rglenn/botboard/BotBoard0507/Documentation/BB07Pro/Photos/Assembly Photos/HPIM0253.JPG

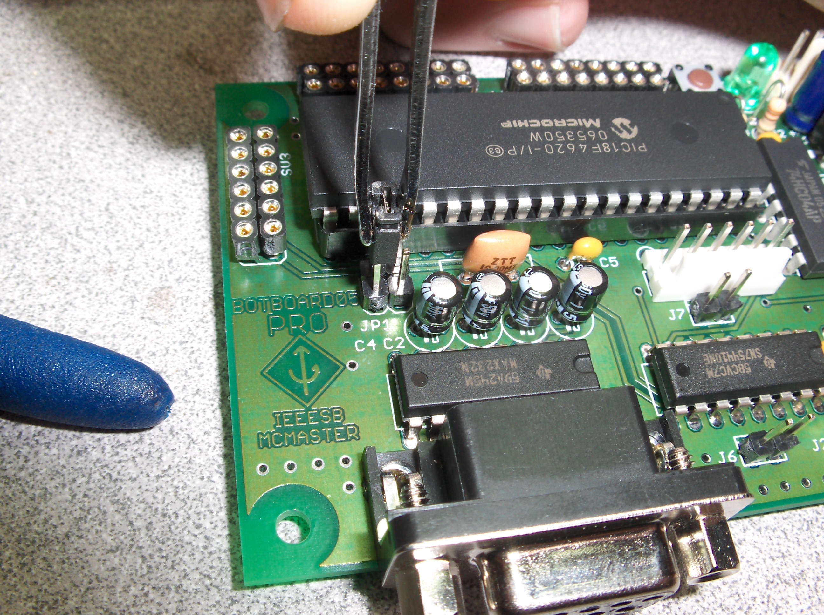
BotBoard0507/Documentation/BB07Pro/Photos/Assembly Photos/HPIM0253.JPG
