rglenn/botboard/BotBoard0507/Documentation/BB05Pro/bb05io_r4.pdf

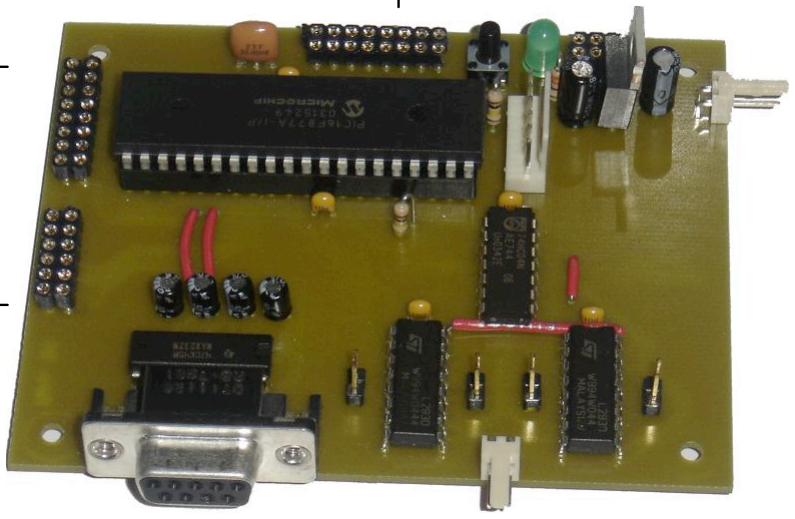
[picture p5: figure]

This picture depicts the BotBoard05 Pro Rev. 4 and its I/O ports. Please note that RC6 and RC7 are unavailable if the wire jumpers to the RS-232 level converter are present, as the MAX232 interferes with their normal, non-serial operation.

The diagram on the next page details the disposition of each I/O pin on the PIC.

GND | GND | GND | GND | GND | GND | GND | GND
RE2 | RE2 | RE1 | RA5 | RA3 | RA2 | RA1 | RA0
GND | RC0
GND | RC1
GND | RC2
GND | RC3
GND | RC4
GND | RC5
GND | RC6
GND | RC7
GND | RD0
GND | RD1
GND | RD2
GND | RD3
GND | RD4
GND | RD5

Copyright © 2005. All rights reserved.

McMaster University
Student Branch

## BotBoard05 Pro

Rev. 4 I/O Map

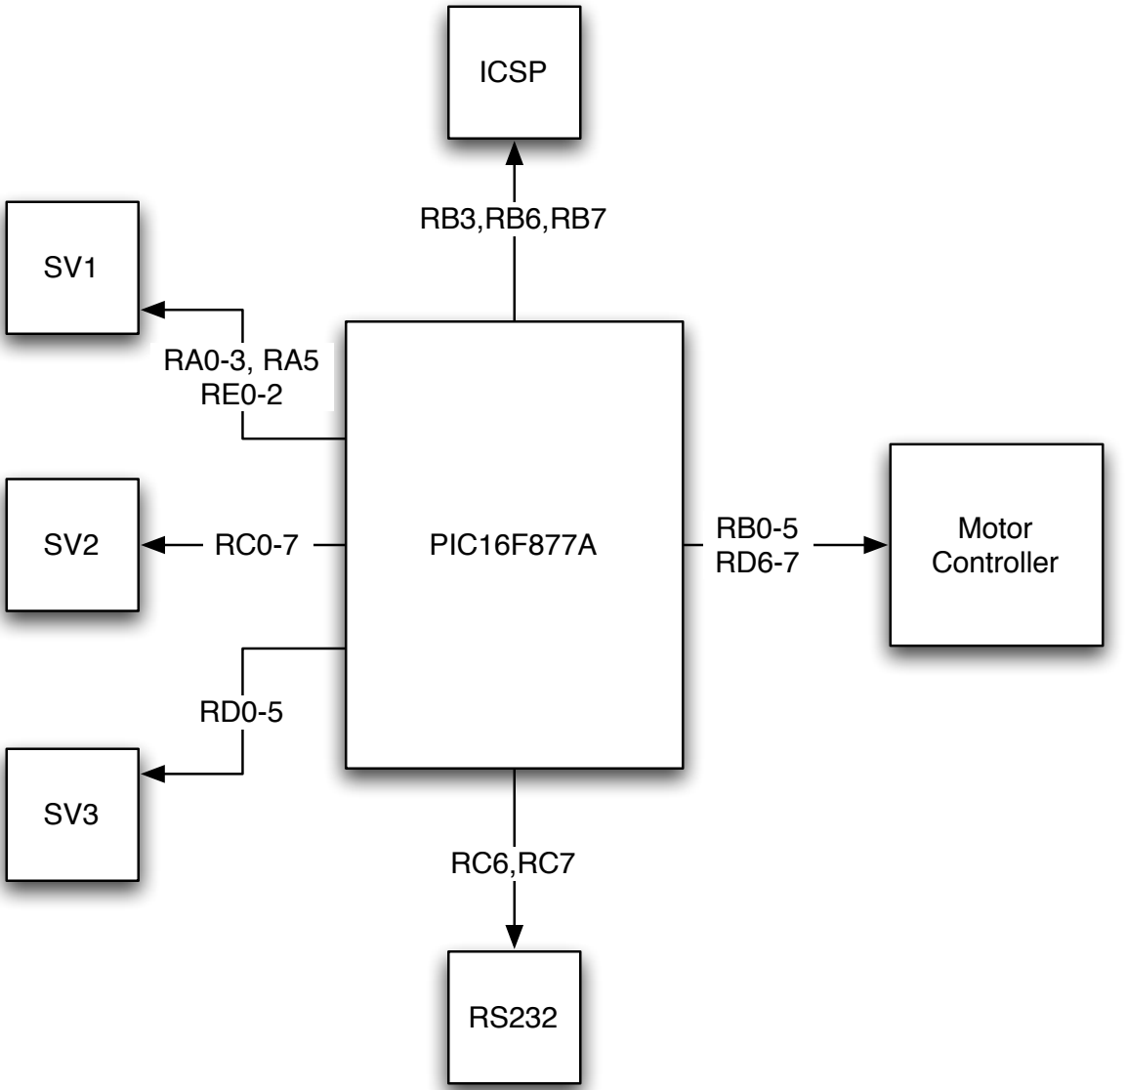
[picture p6: figure]
PIC16F877A; ICSP; Motor Controller

Copyright © 2005. All rights reserved.
