rglenn/botboard/BotBoard0507/Documentation/BB05Pro/bb05io_r5.pdf

GND | GND | GND | GND | GND | GND | GND | GND
RE2 | RE2 | RE1 | RA5 | RA3 | RA2 | RA1 | RA0
GND | RD0
GND | RD1
GND | RD2
GND | RD3
GND | RD4
GND | RD5
GND | GND | GND | GND | GND | GND | GND | GND
RC7 | RC6 | RC5 | RC4 | RC3 | RC2 | RC1 | RC0

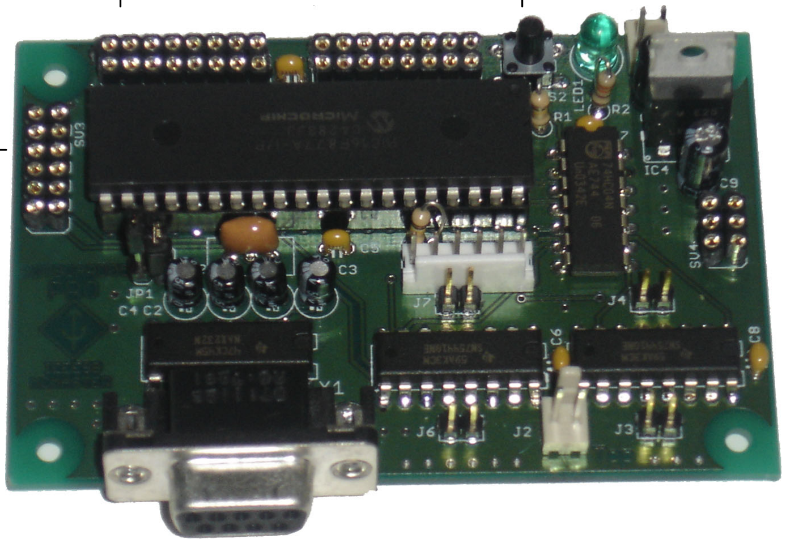
[picture p7: figure]

This picture depicts the BotBoard05 Pro Rev. 5 and its I/O ports. Please note that RC6 and RC7 are unavailable if the jumpers at JP1 to the RS-232 level converter are present, as the MAX232 interferes with their normal, non-serial operation. If you do not need the serial port for bootloading or communications, feel free to remove these jumpers to reclaim those I/O pins.

The diagram on the next page details the disposition of each I/O pin on the PIC.

Copyright © 2005. All rights reserved.

McMaster University
Student Branch

## BotBoard05 Pro

Rev. 5 I/O Map

PIC16F877A; ICSP; Motor Controller

PCBs sponsored by

Copyright © 2005. All rights reserved.
