rglenn/botboard/BotBoard0507/Documentation/BB05Pro/BotBoard05 IO Map R5.pages/droppedImage-1.pdf

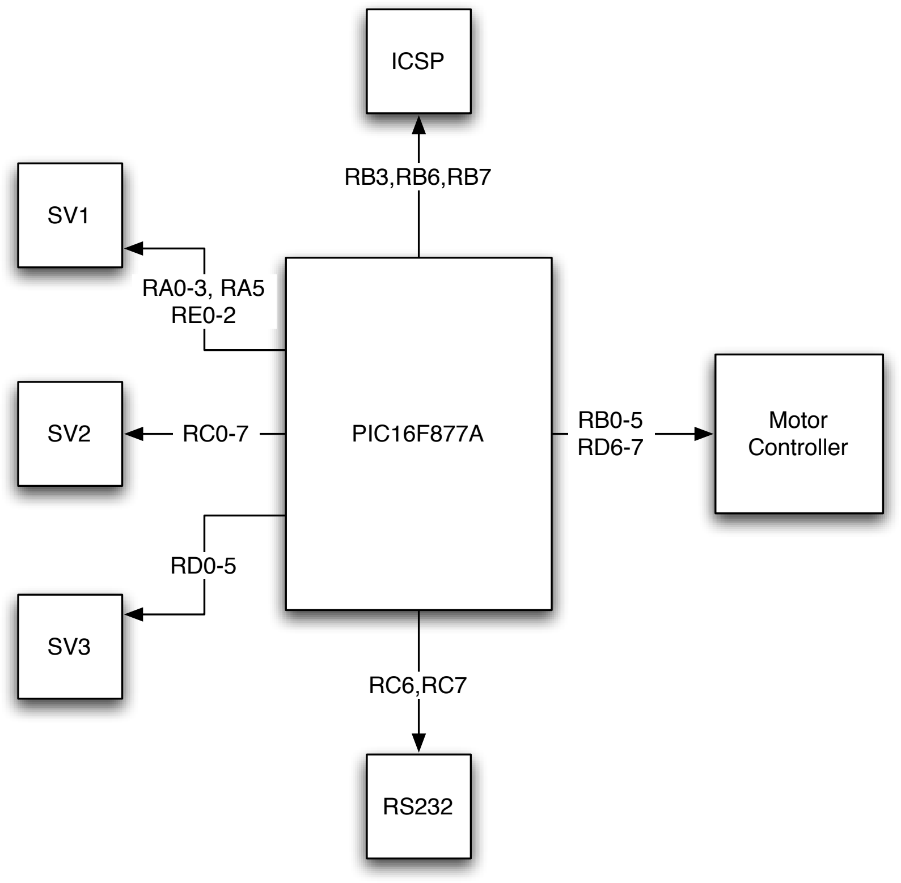
[picture p10: page 1]

PIC16F877A

ICSP

RS232

RC6,RC7

RB3,RB6,RB7

Motor
Controller

RB0-5
RD6-7

SV1

RA0-3, RA5
RE0-2
SV2 | RC0-7

SV3

RD0-5
