rglenn/botboard/BotBoard0507/Documentation/BB05Pro/BotBoard05 Pro Spec Sheet R5.pages/MBblue.pdf

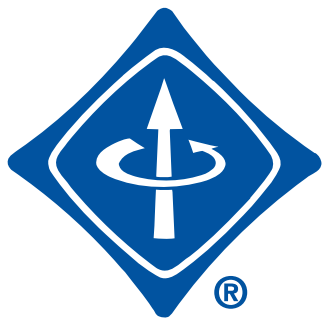
[picture p11: figure]
