rglenn/botboard/BotBoard0507/Documentation/BB05Pro/BB05Pro Port Layout.graffle/image6.jpg

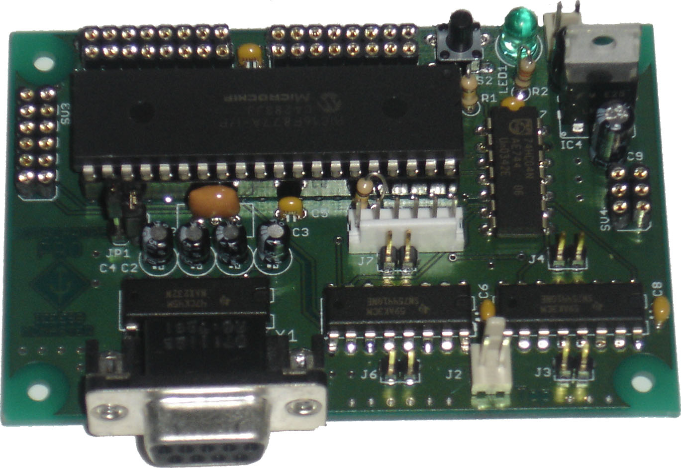
BotBoard0507/Documentation/BB05Pro/BB05Pro Port Layout.graffle/image6.jpg
