rglenn/botboard/BotBoard0507/Documentation/BB05Pro/Photos/bb05pics/DSC00555.JPG

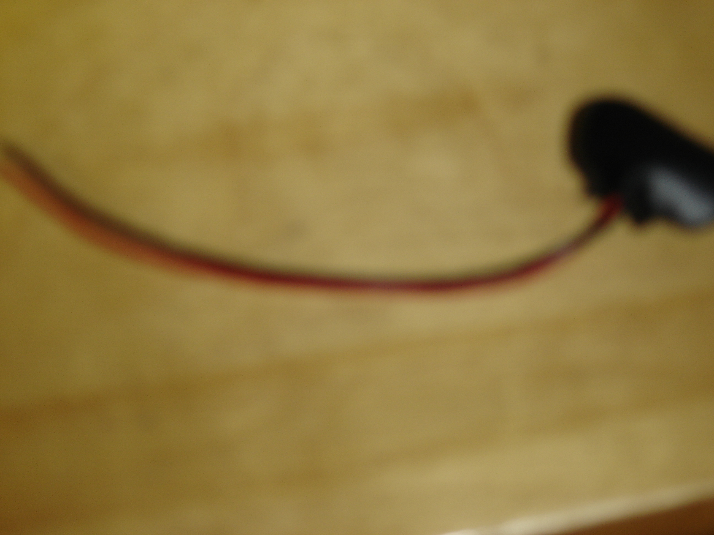
BotBoard0507/Documentation/BB05Pro/Photos/bb05pics/DSC00555.JPG
