rglenn/botboard/BotBoard0507/Documentation/BB05Pro/Photos/bb05pics/DSC00568.JPG

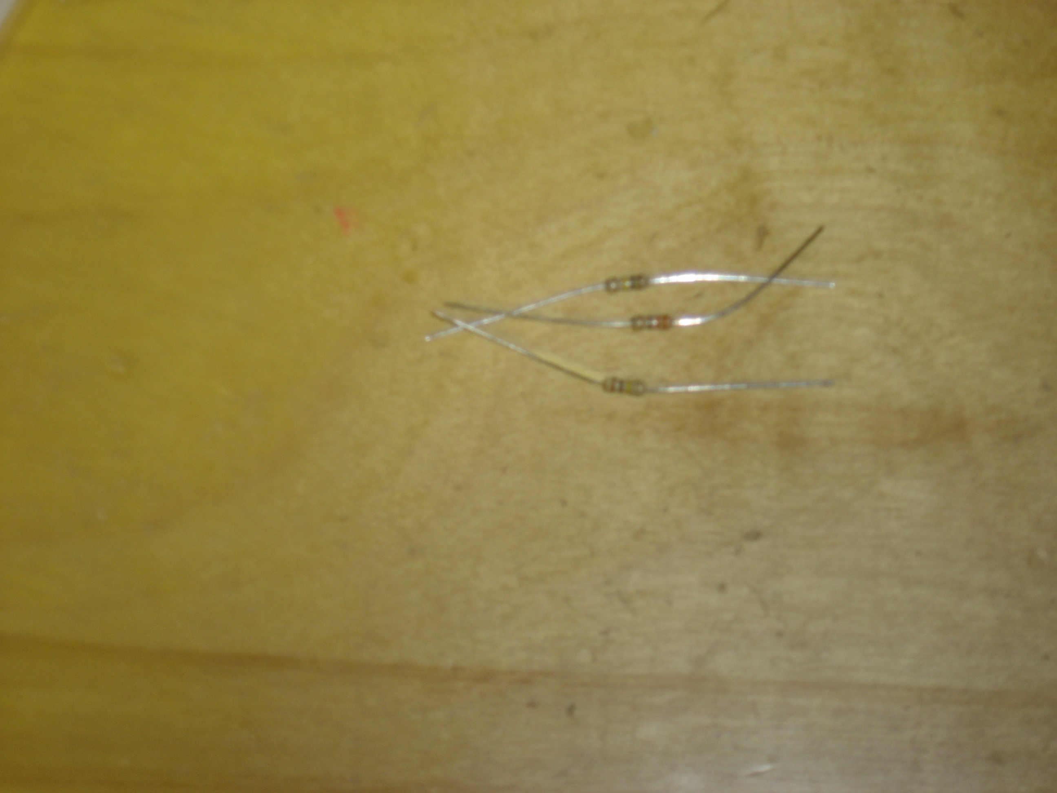
BotBoard0507/Documentation/BB05Pro/Photos/bb05pics/DSC00568.JPG
