rglenn/botboard/BotBoard0507/Documentation/BB05Pro/Photos/bb05pics/DSC00574.JPG

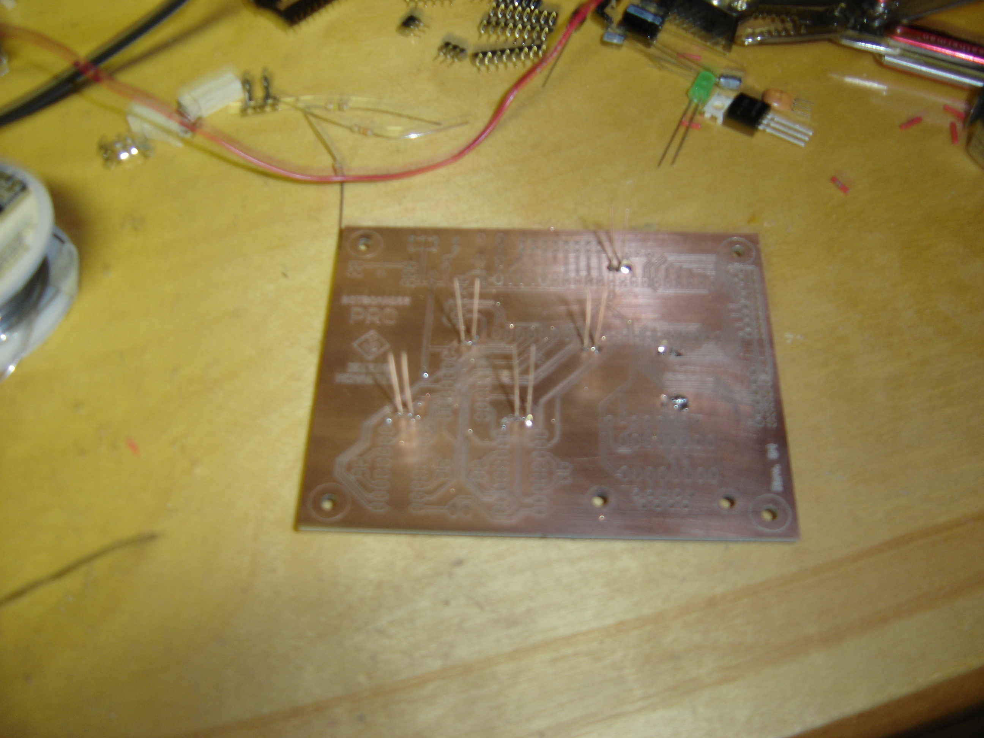
BotBoard0507/Documentation/BB05Pro/Photos/bb05pics/DSC00574.JPG
