rglenn/botboard/BotBoard0507/Documentation/BB05Pro/Photos/bb05pics/DSC00592.JPG

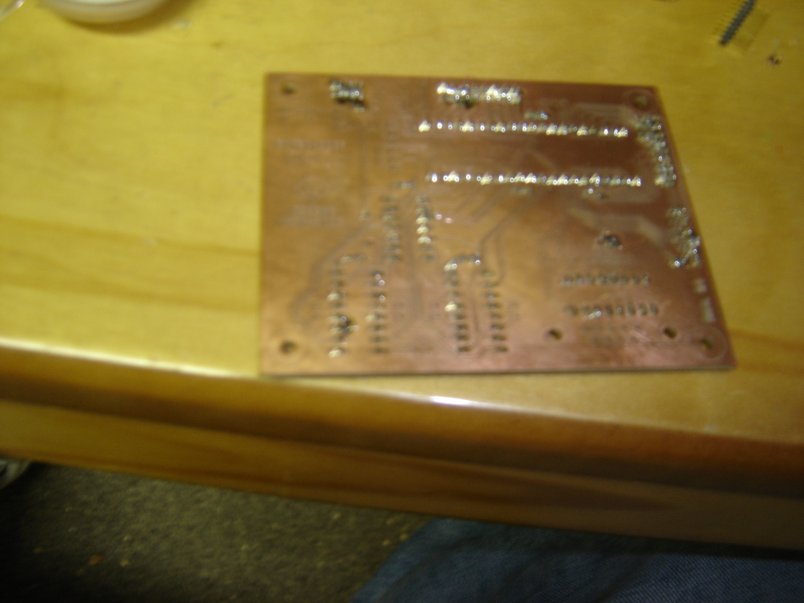
BotBoard0507/Documentation/BB05Pro/Photos/bb05pics/DSC00592.JPG
