rglenn/botboard/BotBoard0507/Documentation/BB05Pro/Photos/bb05pics/DSC00594.JPG

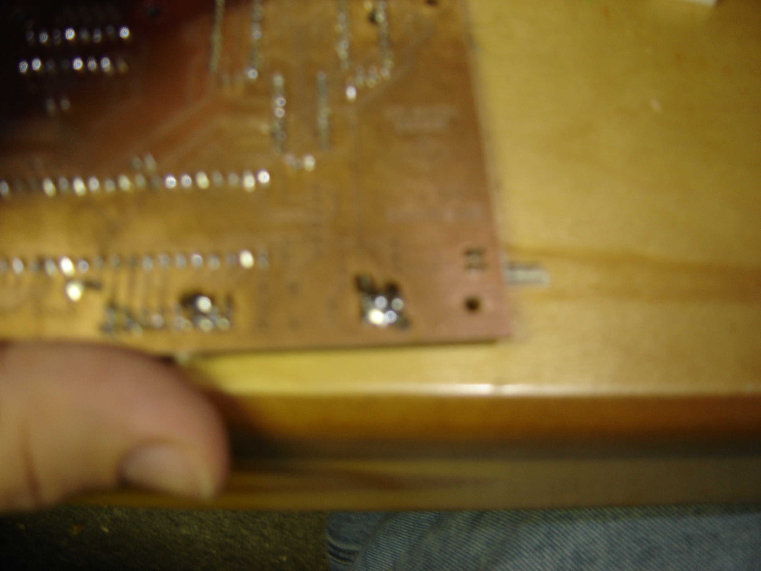
BotBoard0507/Documentation/BB05Pro/Photos/bb05pics/DSC00594.JPG
