rglenn/botboard/BotBoard0507/Documentation/BB05Pro/Photos/bb05pics/DSC00598.JPG

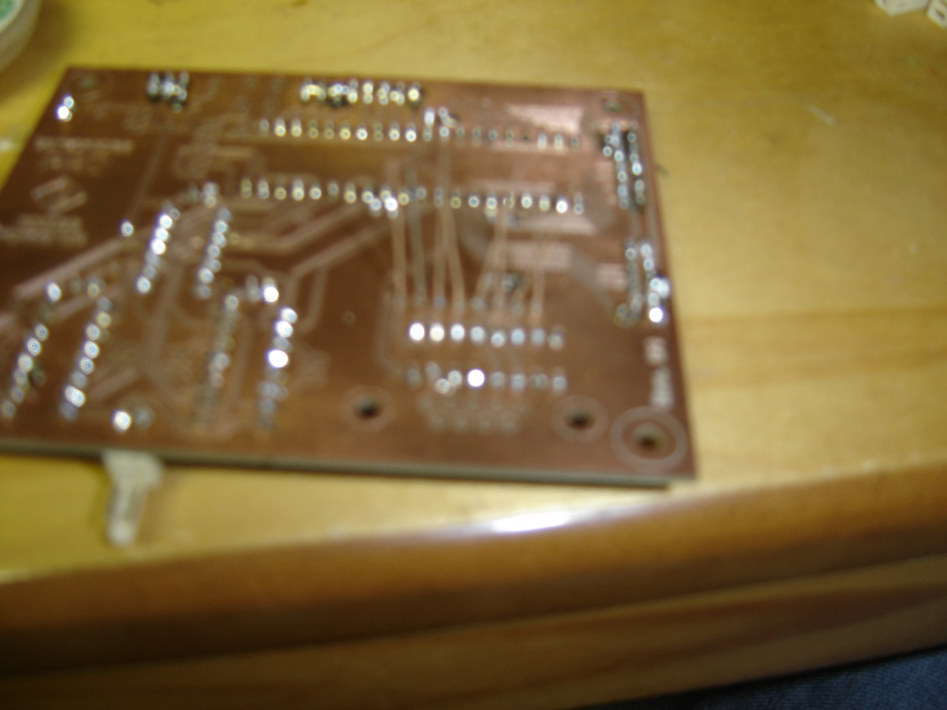
BotBoard0507/Documentation/BB05Pro/Photos/bb05pics/DSC00598.JPG
