rglenn/botboard/BotBoard0507/Documentation/BB05Pro/Photos/bb05pics/DSC00604.JPG

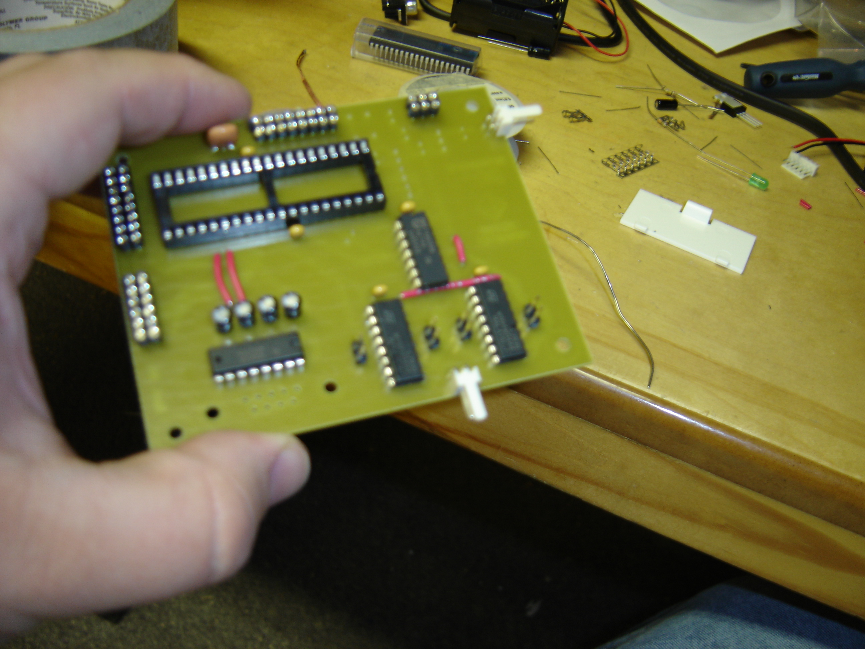
BotBoard0507/Documentation/BB05Pro/Photos/bb05pics/DSC00604.JPG
