rglenn/botboard/BotBoard0507/Documentation/BB05Pro/Photos/bb05pics/DSC00609.JPG

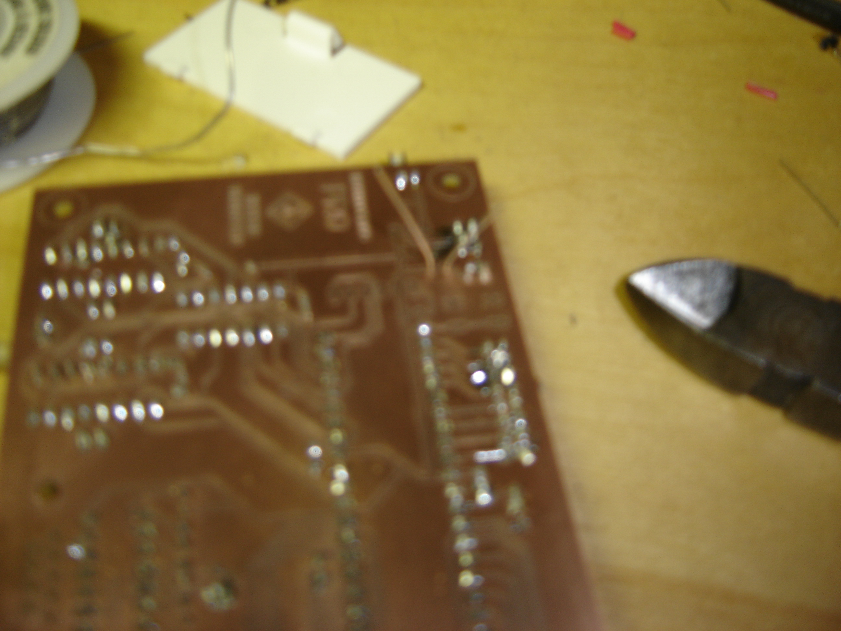
BotBoard0507/Documentation/BB05Pro/Photos/bb05pics/DSC00609.JPG
