rglenn/botboard/BotBoard0507/Documentation/BB05Pro/Photos/bb05pics/DSC00636.JPG

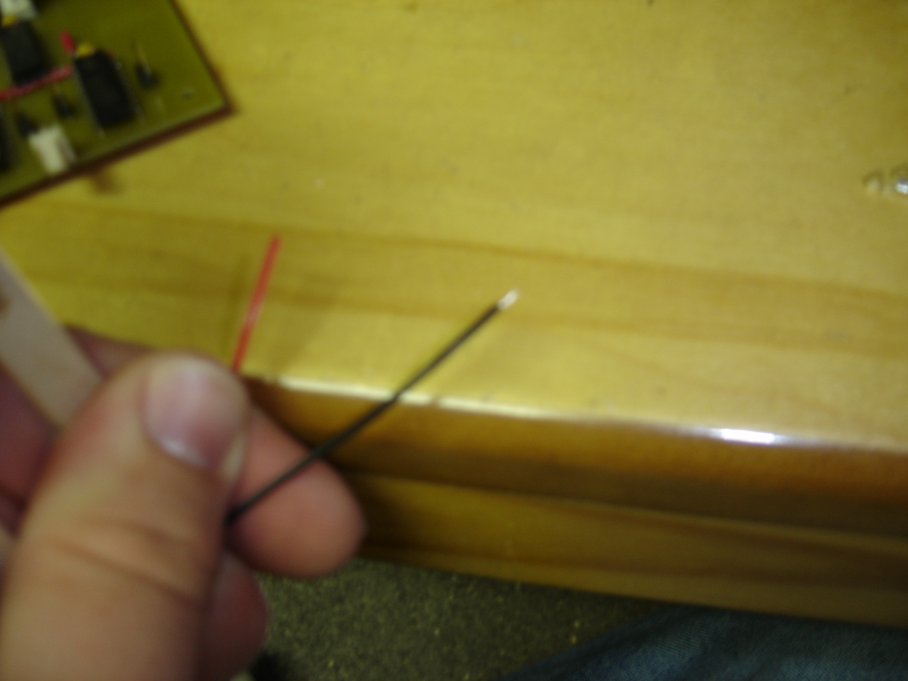
BotBoard0507/Documentation/BB05Pro/Photos/bb05pics/DSC00636.JPG
