rglenn/botboard/BotBoard0507/Documentation/BB05Pro/Photos/bb05r5pics/DSC00731.JPG

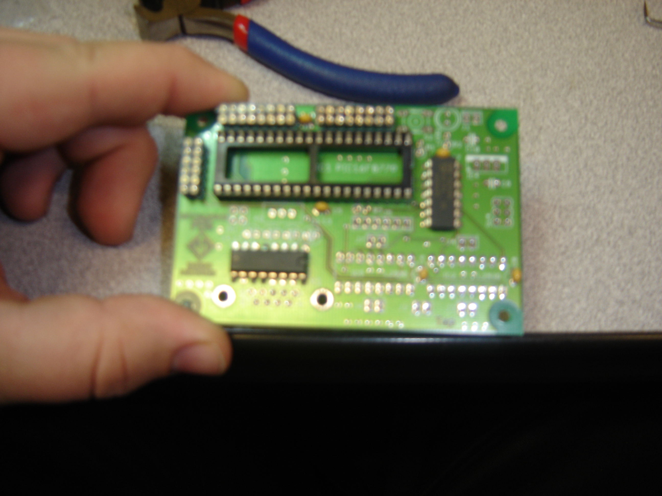
BotBoard0507/Documentation/BB05Pro/Photos/bb05r5pics/DSC00731.JPG
