rglenn/botboard/BotBoard0507/Documentation/BB05Pro/Photos/bb05r5pics/DSC00734.JPG

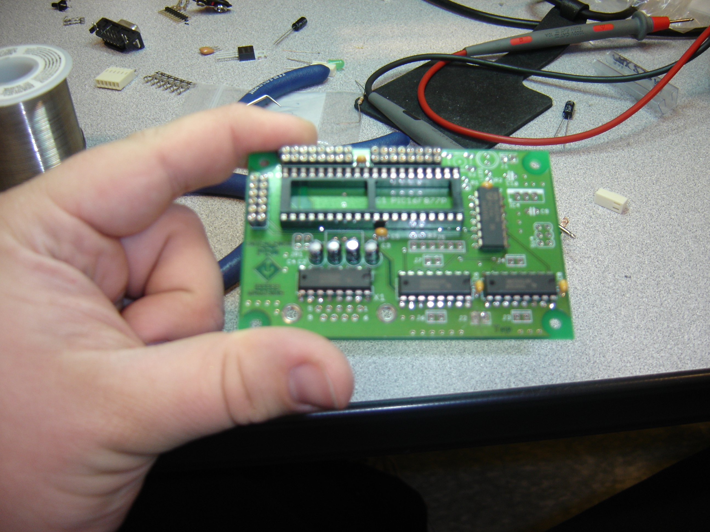
BotBoard0507/Documentation/BB05Pro/Photos/bb05r5pics/DSC00734.JPG
