rglenn/botboard/BotBoard0507/Documentation/BB05Pro/Photos/DSC00753.JPG

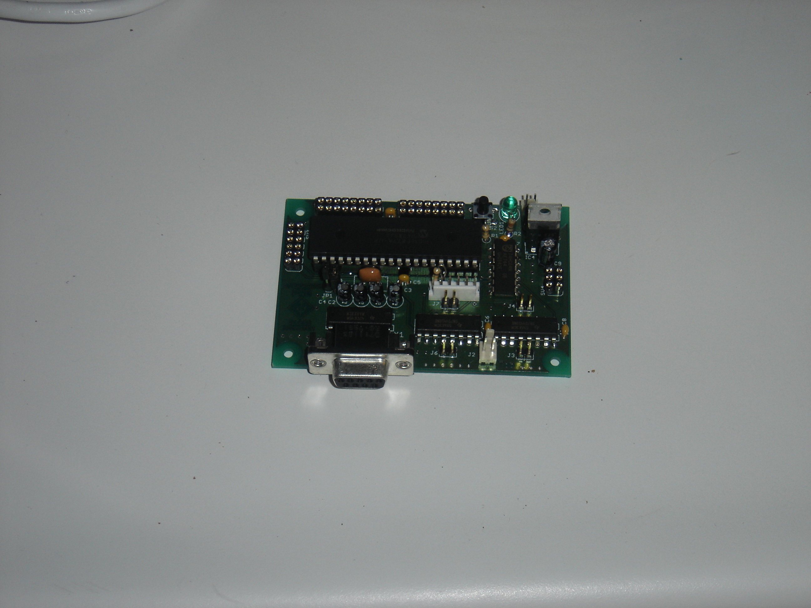
BotBoard0507/Documentation/BB05Pro/Photos/DSC00753.JPG
