rglenn/botboard/BotBoard0507/Documentation/BB05Pro/Photos/DSC00754.JPG

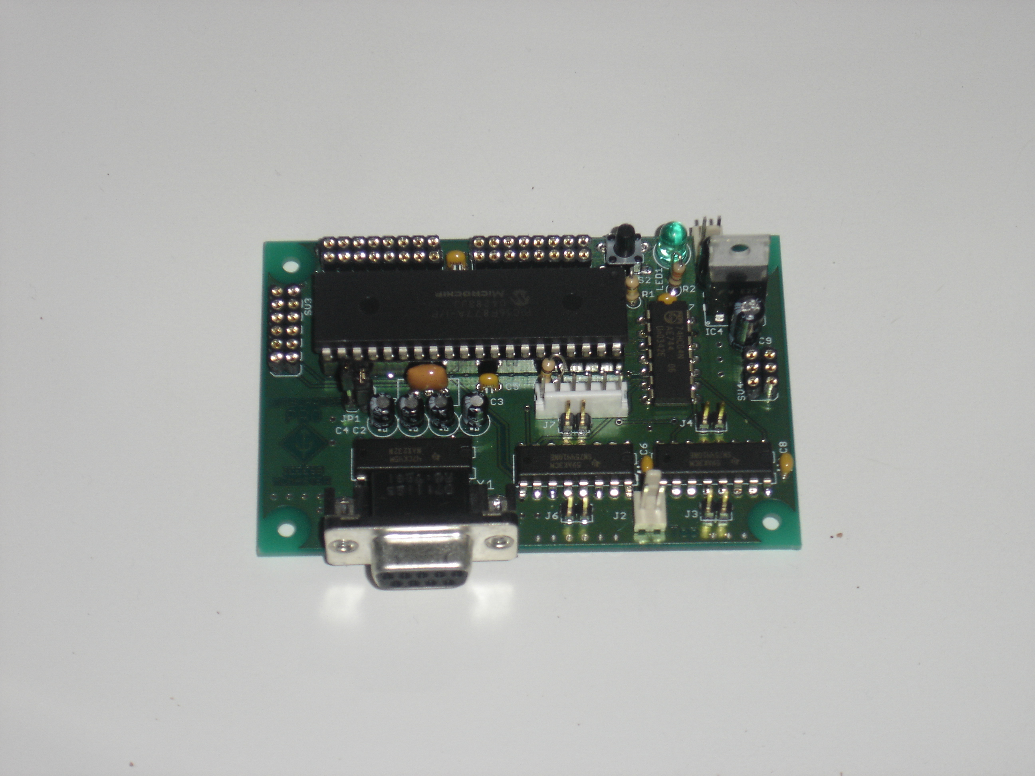
BotBoard0507/Documentation/BB05Pro/Photos/DSC00754.JPG
