rglenn/botboard/BotBoard0507/Hardware/board.png

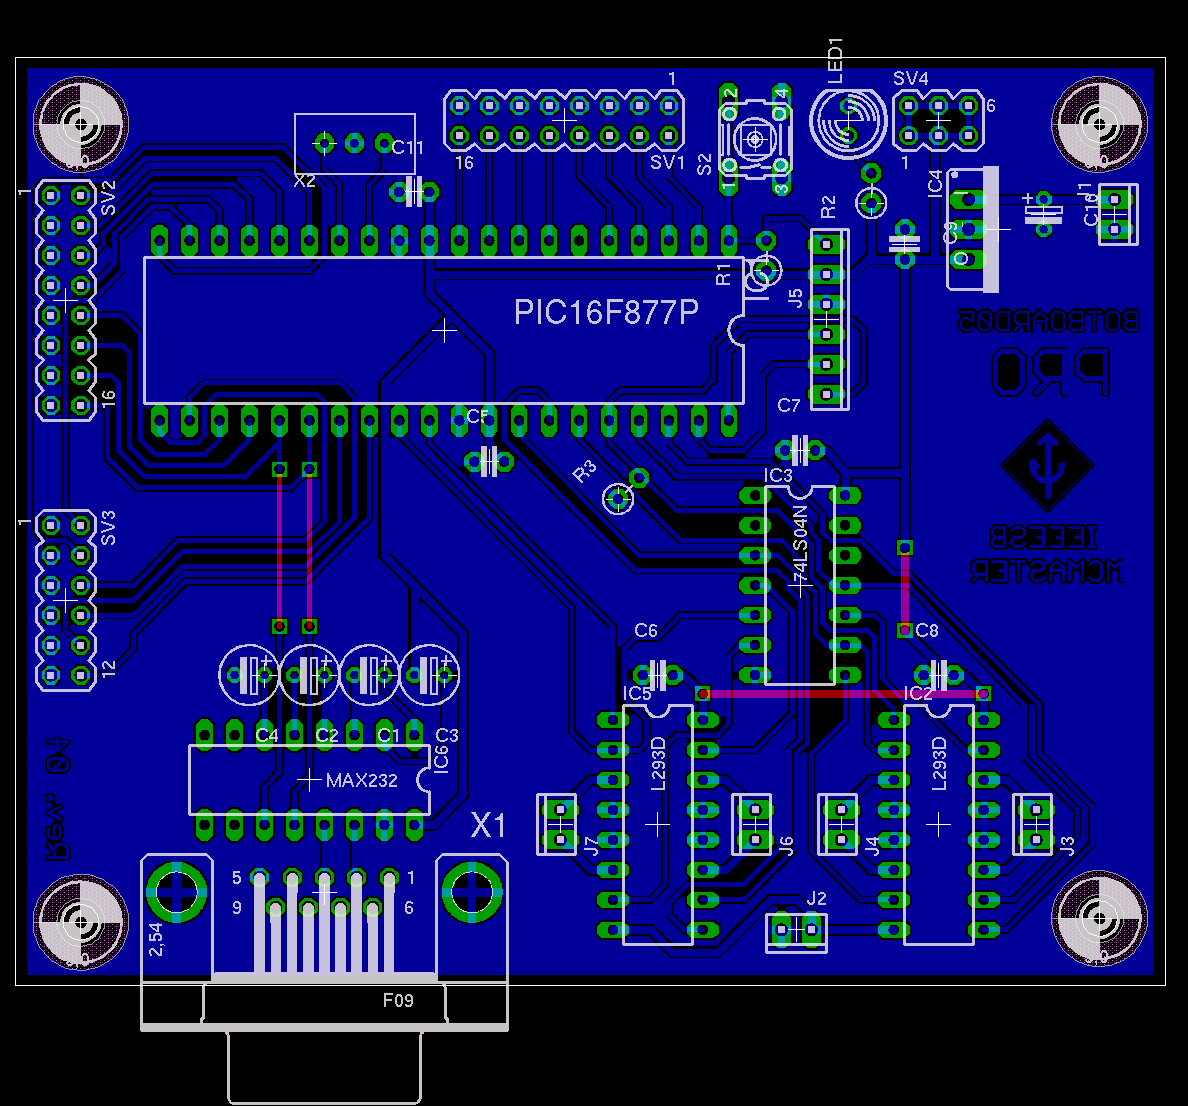
BotBoard0507/Hardware/board.png
