rglenn/botboard/BotBoard0507/Hardware/board_r5.png

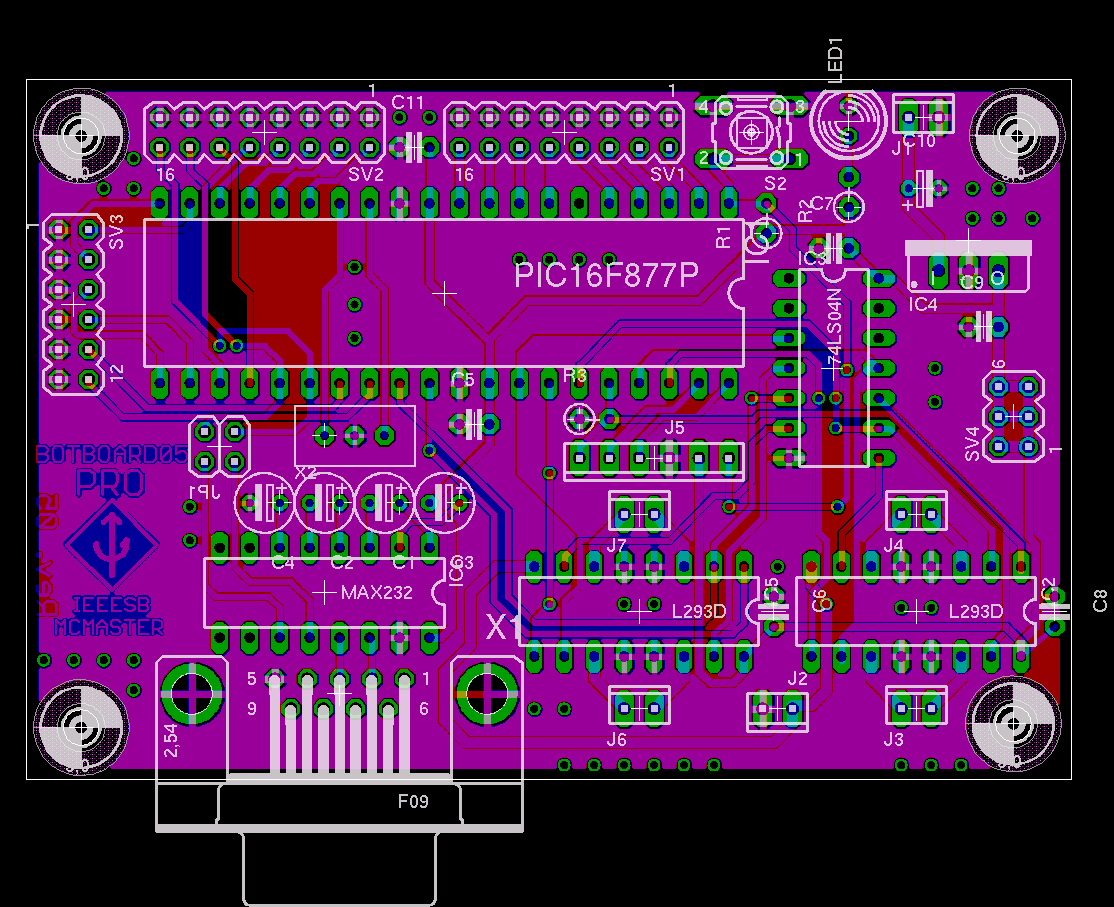
BotBoard0507/Hardware/board_r5.png
