rglenn/botboard/BotBoard0507/Hardware/schematic.png

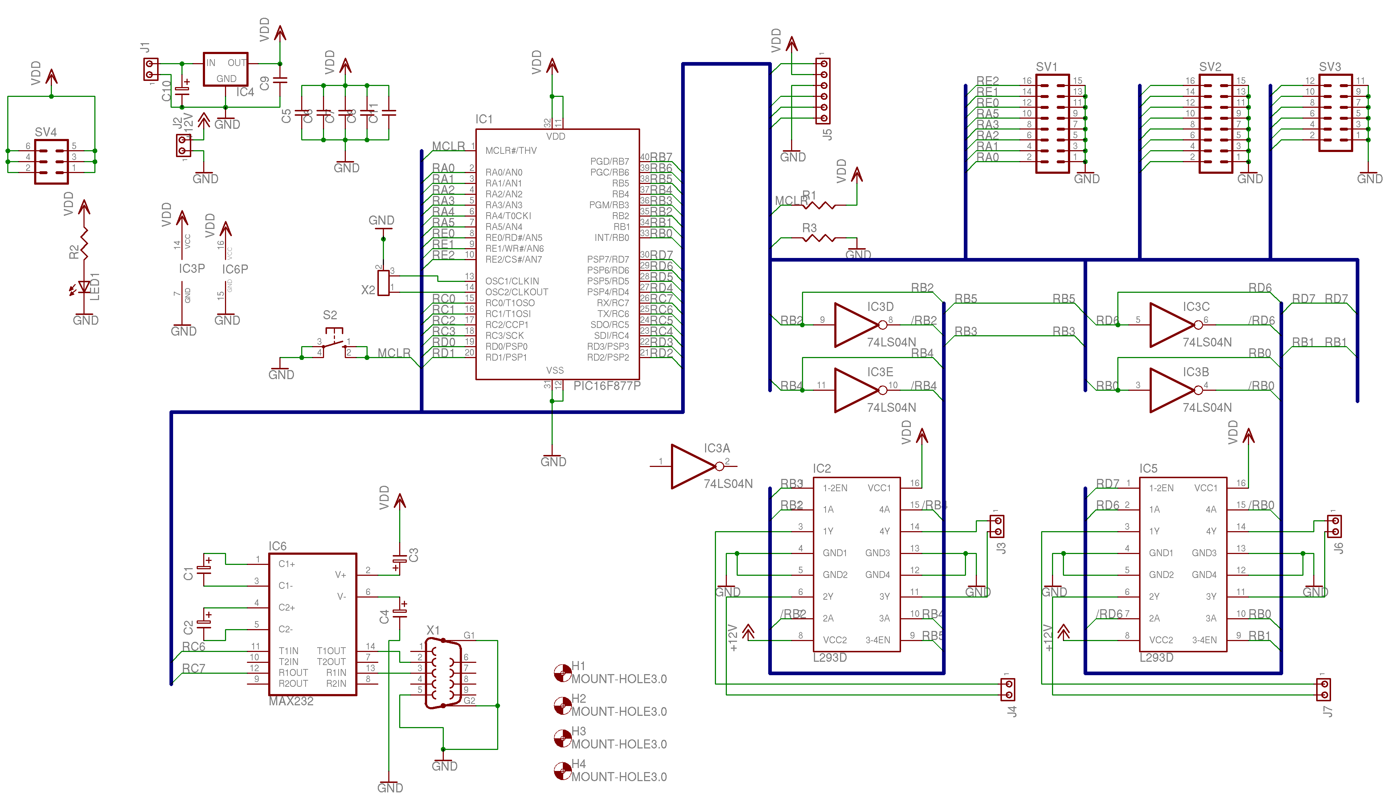
BotBoard0507/Hardware/schematic.png
