rglenn/botboard/BotBoard0507/Hardware/BotBoard 05 BOM.xls

Part Identifier | Value | Type | Quanitity | Reccommended Source | Price each
C1-C4 | 1 µF | Electrolytic Capacitor | 4 | Glitchbuster, Sayal, Supremetronic | 0.10-0.25
C5-C8,C11 | 0.1µF | Non-polarized capacity | 5 | Glitchbuster, Sayal, Supremetronic | 0.10-0.20
C9 | 10 µF | Electrolytic Capacitor | 1 | Glitchbuster, Sayal, Supremetronic | 0.2
C10 | 47 µF | Electrolytic Capacitor | 1 | Glitchbuster, Sayal, Supremetronic | 0.2
IC1 | PIC16F877A/P | Microcontroller | 1 | Microchip, Digikey | 0-5
IC2,IC5 | L293D | Quad half H-bridge | 2 | Digikey, Glitchbuster, Sayal | 2
IC3 | 74LS04N | Hex Inverter | 1 | Glitchbuster, Sayal, Supremetronic | 0.4
IC4 | LM7805 | 5 volt regulator | 1 | Glitchbuster, Sayal, Supremetronic | 0.5
IC6 | MAX232 | RS232 Level Converter | 1 | Glitchbuster, Sayal, Supremetronic | 1
J3,J4,J6,J7 |  | 2-pin header | 4 | Glitchbuster, Sayal, Supremetronic | 0.1
J1,J2 |  | 2-pin polarized header | 2 | Supremetronic | 0.15
J5 |  | 6-pin polarized header | 1 | Supremetronic | 0.45
LED1 | Green | 5mm LED | 1 | Glitchbuster, Sayal, Supremetronic | 0.15
R1,R3 | 100kΩ | Resistor | 2 | Glitchbuster, Sayal, Supremetronic | 0.05
R2 | 330Ω | Resistor | 1 | Glitchbuster, Sayal, Supremetronic | 0.05
S2 |  | Omron Switch | 1 | Supremetronic, A1 Parts, Digikey | 1
SV1-SV4 |  | Female machined pin socket | 4 | A1 Parts, Supremetronic, Digikey | 0.5
X1 | DB9FHP | Female DB9 right angle PCB mount | 1 | Supremetronic, Sayal | 0.75
X2 | 20MHz | ZTT resonator | 1 | Glitchbuster, Supremetronic | 1
 |  | Botboard 05 PCB | 1 | IEEESB McMaster | 15
 |  | 9V battery snap | 1 | Supremetronic, Sayal | 0.4
 |  | 4xAA battery pack | 1 | Supremetronic, Sayal, Active Surplus | 1
