rglenn/botboard/BotBoard0507/Documentation/BB05Pro/bb05probom.xls

BotBoard05 Pro Bill of Materials
Identifier | Value | Type | Quanitity
C1-C4 | 1 µF | Electrolytic Capacitor | 4
C5-C8,C11 | 0.1µF | Non-polarized capacity | 5
C9 | 10 µF | Electrolytic Capacitor | 1
C10 | 47 µF | Electrolytic Capacitor | 1
IC1 | PIC16F877A/P | Microcontroller | 1
IC2,IC5 | L293D | Quad half H-bridge | 2
IC3 | 74LS04N | Hex Inverter | 1
IC4 | LM7805 | 5 volt regulator | 1
IC6 | MAX232 | RS232 Level Converter | 1
J3,J4,J6,J7 |  | 2-pin header | 4
J1,J2 |  | 2-pin polarized header | 2
J5 |  | 6-pin polarized header | 1
LED1 | Green | 5mm LED | 1
R1,R3 | 100kΩ | Resistor | 2
R2 | 330Ω | Resistor | 1
S2 |  | Omron Switch | 1
SV1-SV4 |  | Female machined pin socket | 4
X1 | DB9FHP | Female DB9 right angle PCB mount | 1
X2 | 20MHz | ZTT resonator | 1
 |  | Botboard 05 PCB | 1
 |  | 9V battery snap | 1
 |  | 4xAA battery pack | 1
