rglenn/botboard/(list of files, cad)

Other CAD files:
BotBoard0507/Software/Sample Code/BotBoard05/bb_motor/motor.obj
BotBoard0507/Software/Sample Code/BotBoard05/bbtest/delaytest.obj
BotBoard0507/Software/Sample Code/BotBoard05/bbtest/delay.obj
