rglenn/botboard/BotBoard0507/Documentation/BB07Pro/BotBoard07 Pro Build Instructions.pages/HPIM0243.JPG

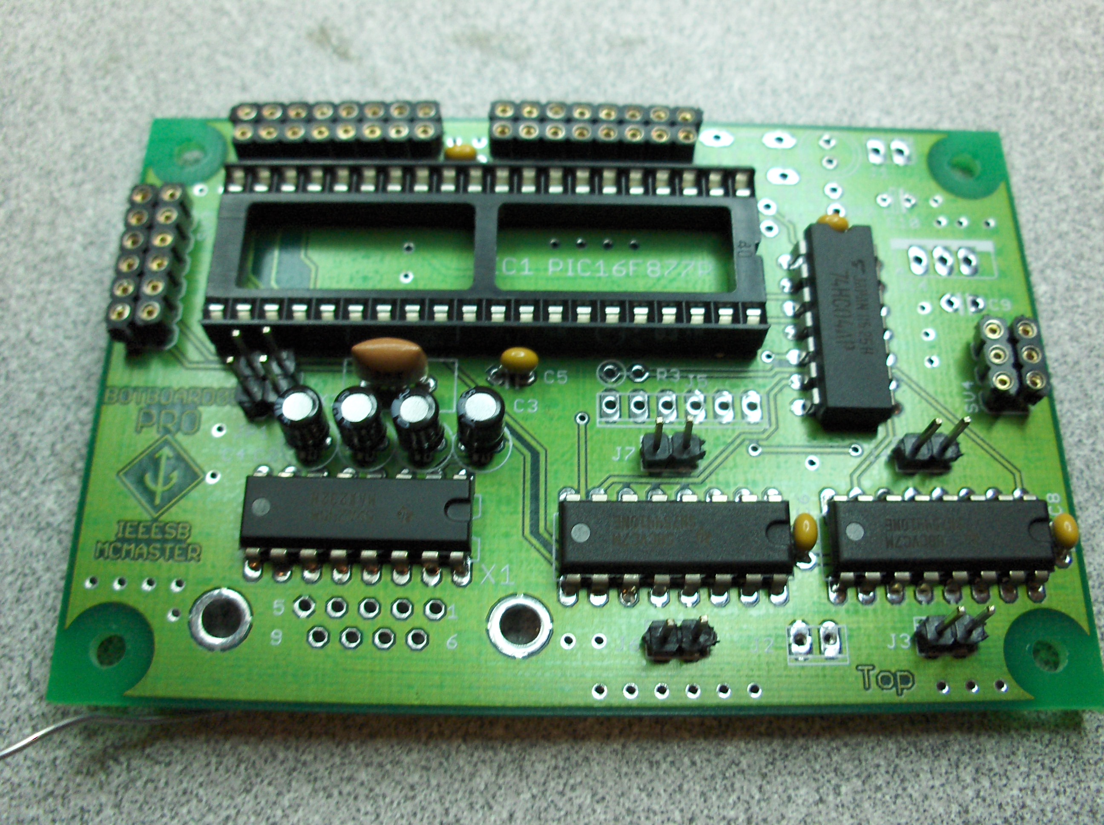
BotBoard0507/Documentation/BB07Pro/BotBoard07 Pro Build Instructions.pages/HPIM0243.JPG
