rglenn/botboard/BotBoard0507/Documentation/BB07Pro/BotBoard07 Pro Build Instructions.pages/HPIM0246.JPG

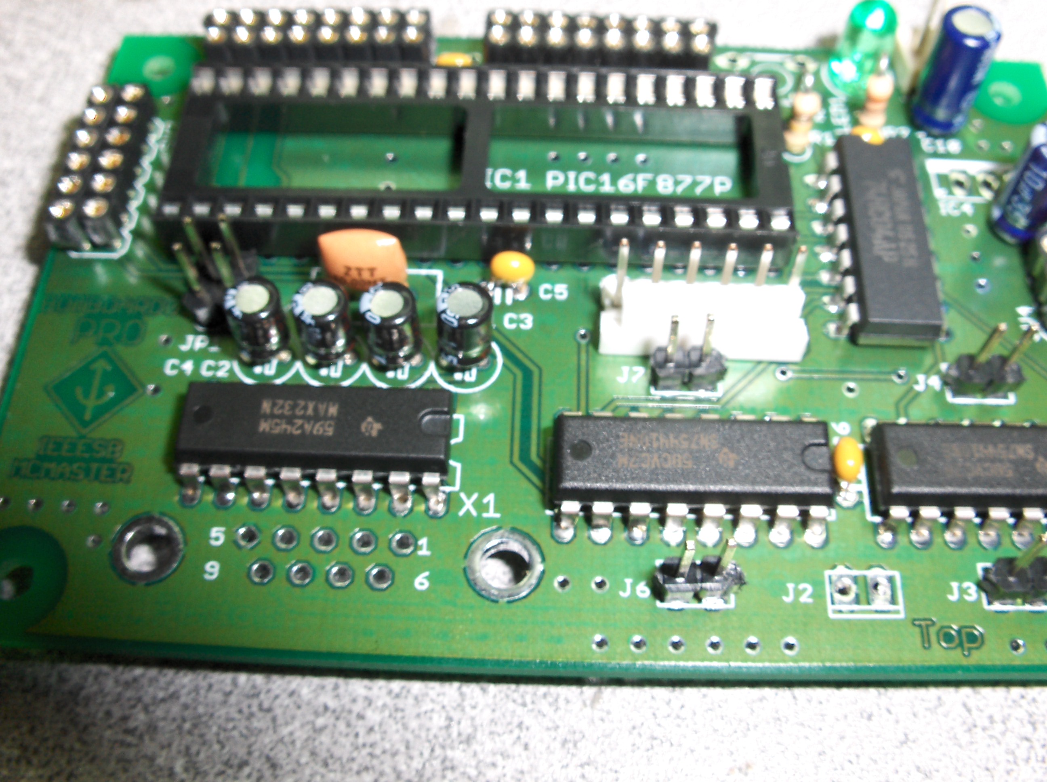
BotBoard0507/Documentation/BB07Pro/BotBoard07 Pro Build Instructions.pages/HPIM0246.JPG
