rglenn/botboard/BotBoard0507/Documentation/BB07Pro/Photos/Assembly Photos/HPIM0247.JPG

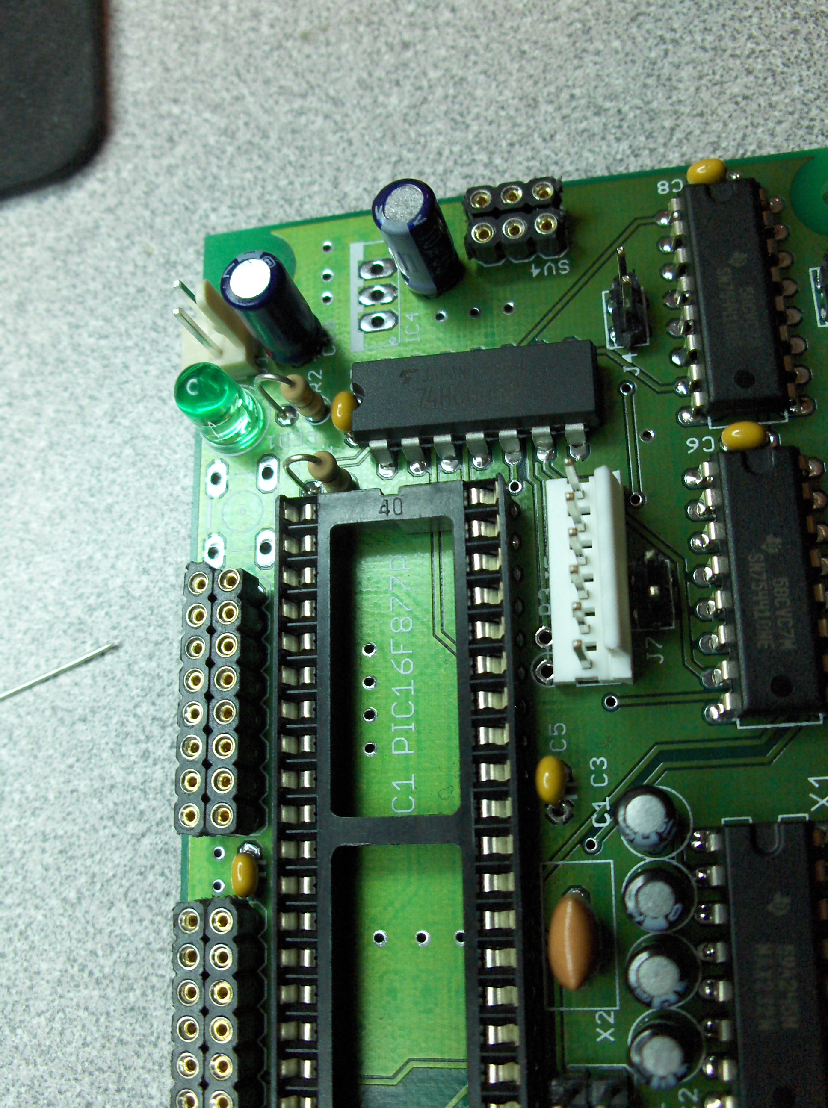
BotBoard0507/Documentation/BB07Pro/Photos/Assembly Photos/HPIM0247.JPG
