rglenn/botboard/BotBoard0507/Documentation/BB07Pro/Photos/Assembly Photos/HPIM0248.JPG

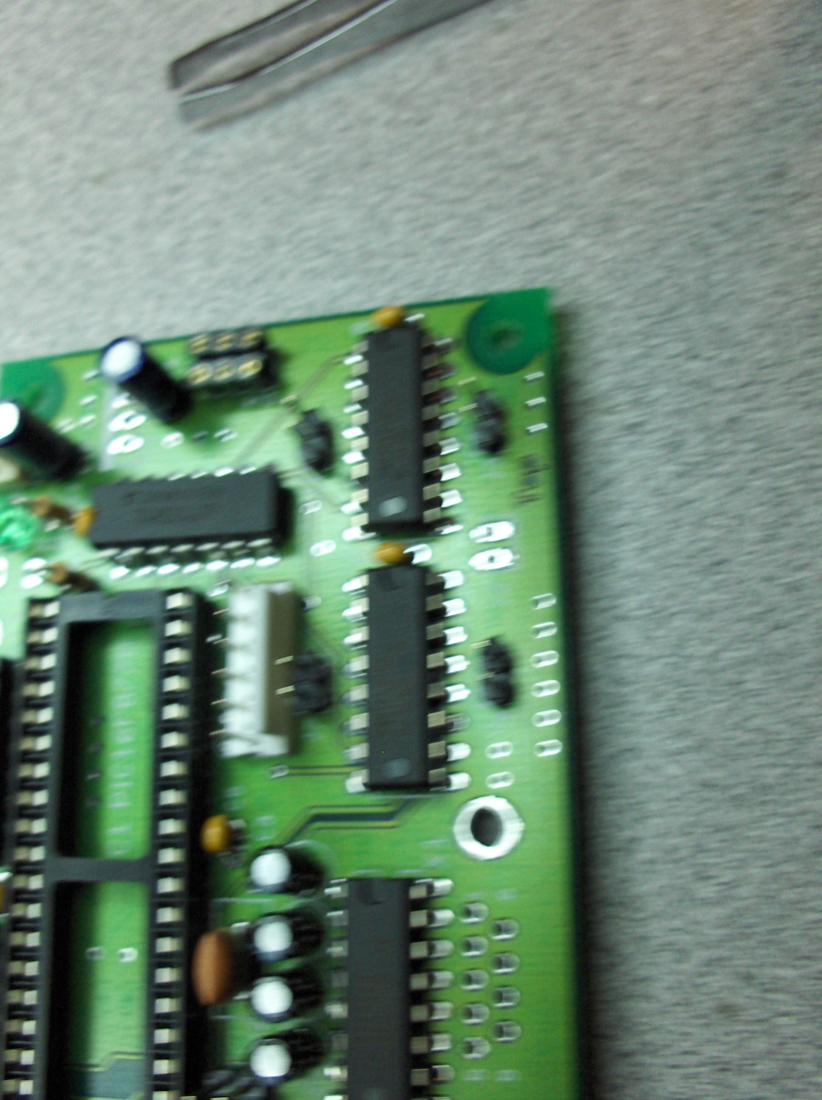
BotBoard0507/Documentation/BB07Pro/Photos/Assembly Photos/HPIM0248.JPG
