rglenn/botboard/BotBoard0507/Software/Bootloaders/tinybld193/tinybld.ini

[FILES]
HexFile=

[PIC]
COMport=COM1
COMspeed=115200

[WINDOW]
Top=100
Left=100
Width=576
Height=380

[OPTIONS]
PreCodes=
PulseRTS=0
ActiveRTS=0
useDTR=0
SearchDelay=5
Timeout=300
SearchForCOMs=0
AutoClose=0
SizeOfBLD_W=100

[TERMINAL]
TerminalBufferLength=10000
SwitchToTerminal=0
