rglenn/botboard/(commit log)

2008-03-30 Initial import of files in progress
    [BotBoardUSB-R1.brd, BotBoardUSB-R1.sch, BotBoardUSBMotor-R1.brd, BotBoardUSBMotor-R1.sch]
2008-03-30 Adding old hardware files, bootloaders.
    [BotBoard 05 BOM.xls, botboardpro-mini-motor.brd, botboardpro-mini-motor.sch, botboardpro-mini.brd, botboardpro-mini.sch, botboardpro-rev1.brd, botboardpro-rev1.sch, botboardpro-rev2.brd]
2008-04-03 Adding BotBoard Documentation stuff
    [bb05probom.xls]
